VincErilla/Quake_Project/README.md

# Quake_Project
All files/programs used in creating the quake sensors
