VincErilla/Quake_Project/Quake-main/PCB/README.txt

Quake_PCB_3 has the most recent pcb for the quake project, the production files are the versions that were ready to go to JLC PCB with 5 being the most recent that includes the rtc.
