VincErilla/Quake_Project/(list of files, drawings)

Other design files:
Quake-main/PCB/Quake_PCB_3/Quake_PCB_3.dsn
