VincErilla/Quake_Project/Quake-main/PCB/Quake_PCB_3/Quake_PCB_3.kicad_pcb

## KiCad design Quake-main/PCB/Quake_PCB_3/Quake_PCB_3.kicad_pcb (2026-06-08)

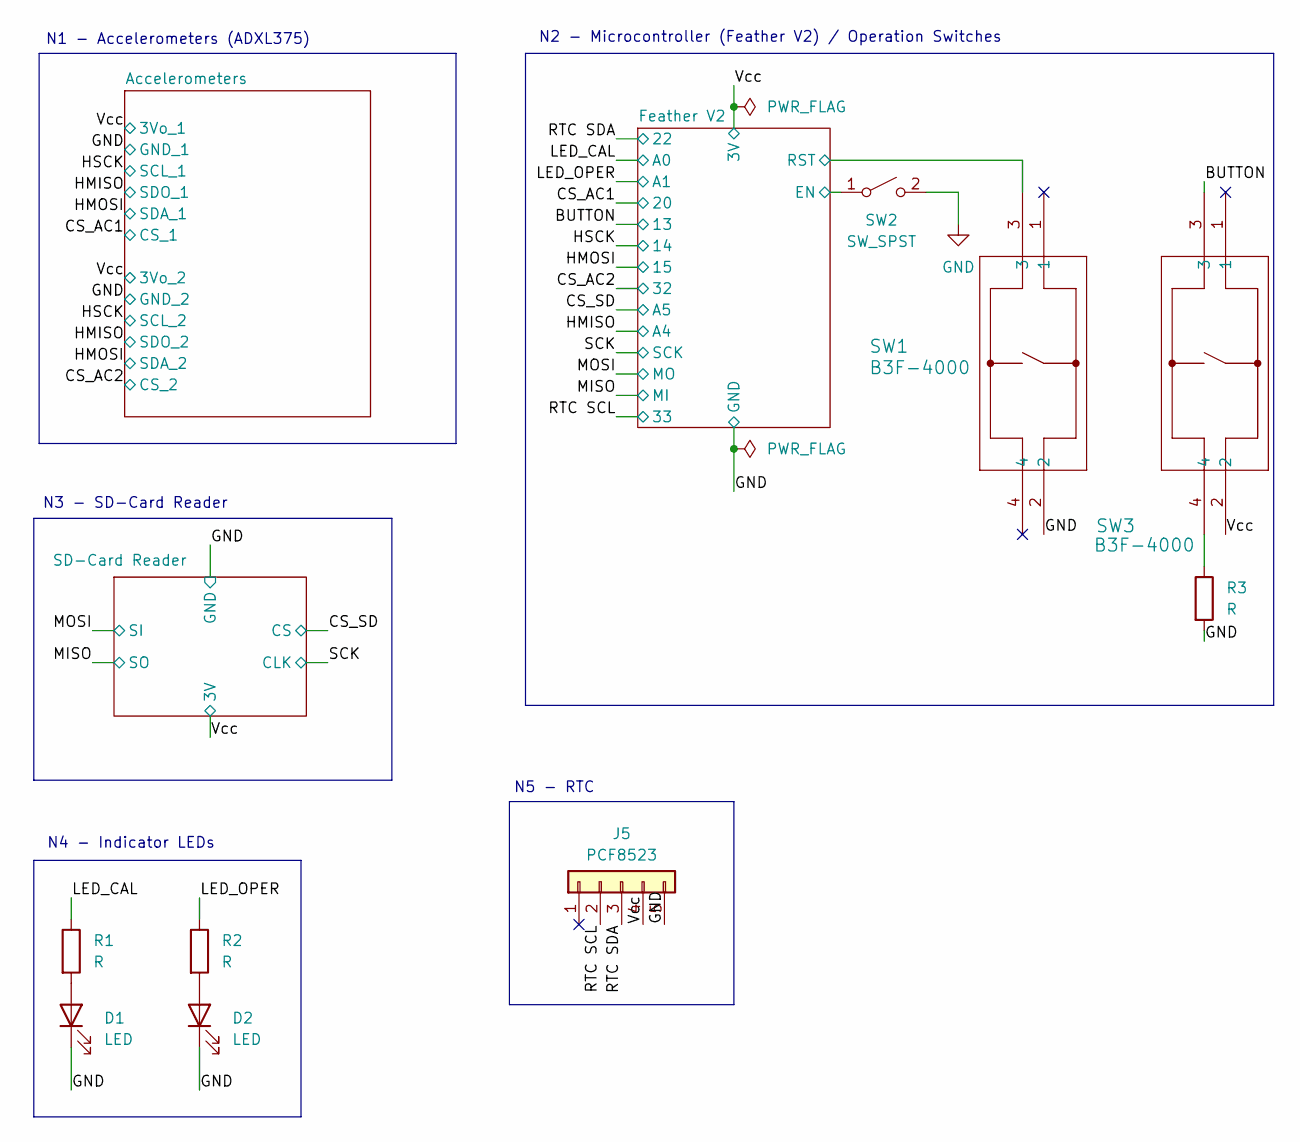
[picture p2: schematic Quake_PCB_3.kicad_sch, Quake PCB]

Parts:
D1, D2: LED; LED_D3.0mm
J5: PCF8523; PinHeader_1x05_P2.54mm_Vertical
R1, R2, R3: R; R_Axial_DIN0204_L3.6mm_D1.6mm_P7.62mm_Horizontal
SW1: B3F-4000; SW_B3F-4000_OMR
SW2: SW_SPST; PinHeader_1x02_P2.54mm_Vertical
SW3: B3F-4000; SW_SPST_Omron_B3F-40xx

Connections:
/BUTTON: SW3.3; also elsewhere on the board
/Feather V2/EN: SW2.1 (A); also elsewhere on the board
/Feather V2/RST: SW1.3; also elsewhere on the board
/LED_CAL: R1.1; also elsewhere on the board
/LED_OPER: R2.1; also elsewhere on the board
/RTC SCL: J5.2 (SCL); also elsewhere on the board
/RTC SDA: J5.3 (SDA); also elsewhere on the board
/Vcc: J5.4 (VCC), SW3.2; also elsewhere on the board
GND: D1.1 (K), D2.1 (K), J5.5 (GND), R3.2, SW1.2, SW2.2 (B); also elsewhere on the board
unnamed: D1.2 (A), R1.2
unnamed: D2.2 (A), R2.2
unnamed: R3.1, SW3.4

Notes on the sheet:
N4 - Indicator LEDs
N3 - SD-Card Reader
N5 - RTC
N1 - Accelerometers (ADXL375)
N2 - Microcontroller (Feather V2) / Operation Switches

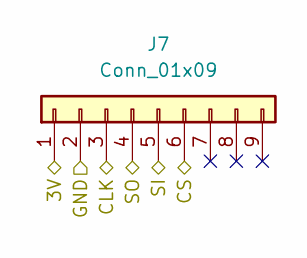
[picture p3: schematic sd_card_reader.kicad_sch]

Parts:
J7: Conn_01x09; PinHeader_1x09_P2.54mm_Vertical

Connections:
/CS_SD: J7.6; also elsewhere on the board
/MISO: J7.4; also elsewhere on the board
/MOSI: J7.5; also elsewhere on the board
/SCK: J7.3; also elsewhere on the board
/Vcc: J7.1; also elsewhere on the board
GND: J7.2; also elsewhere on the board

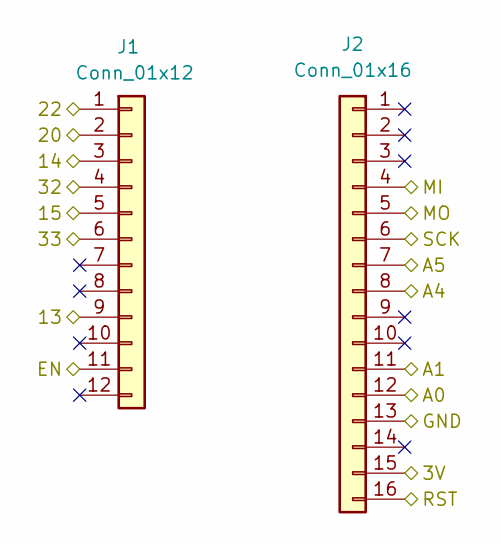
[picture p4: schematic feather_v2.kicad_sch]

Parts:
J1: Conn_01x12; PinHeader_1x12_P2.54mm_Vertical
J2: Conn_01x16; PinHeader_1x16_P2.54mm_Vertical

Connections:
/BUTTON: J1.9; also elsewhere on the board
/CS_AC1: J1.2; also elsewhere on the board
/CS_AC2: J1.4; also elsewhere on the board
/CS_SD: J2.7; also elsewhere on the board
/Feather V2/EN: J1.11; also elsewhere on the board
/Feather V2/RST: J2.16; also elsewhere on the board
/HMISO: J2.8; also elsewhere on the board
/HMOSI: J1.5; also elsewhere on the board
/HSCK: J1.3; also elsewhere on the board
/LED_CAL: J2.12; also elsewhere on the board
/LED_OPER: J2.11; also elsewhere on the board
/MISO: J2.4; also elsewhere on the board
/MOSI: J2.5; also elsewhere on the board
/RTC SCL: J1.6; also elsewhere on the board
/RTC SDA: J1.1; also elsewhere on the board
/SCK: J2.6; also elsewhere on the board
/Vcc: J2.15; also elsewhere on the board
GND: J2.13; also elsewhere on the board

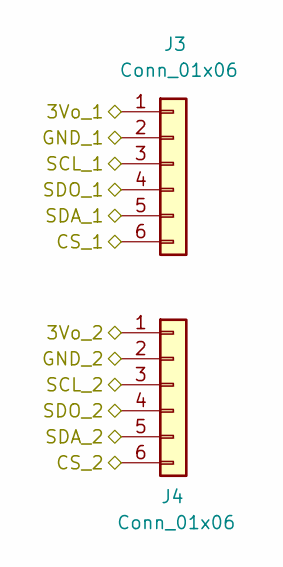
[picture p5: schematic accelerometers.kicad_sch]

Parts:
J3, J4: Conn_01x06; PinHeader_2x03_P2.54mm_Vertical

Connections:
/CS_AC1: J3.6; also elsewhere on the board
/CS_AC2: J4.6; also elsewhere on the board
/HMISO: J3.4, J4.4; also elsewhere on the board
/HMOSI: J3.5, J4.5; also elsewhere on the board
/HSCK: J3.3, J4.3; also elsewhere on the board
/Vcc: J3.1, J4.1; also elsewhere on the board
GND: J3.2, J4.2; also elsewhere on the board

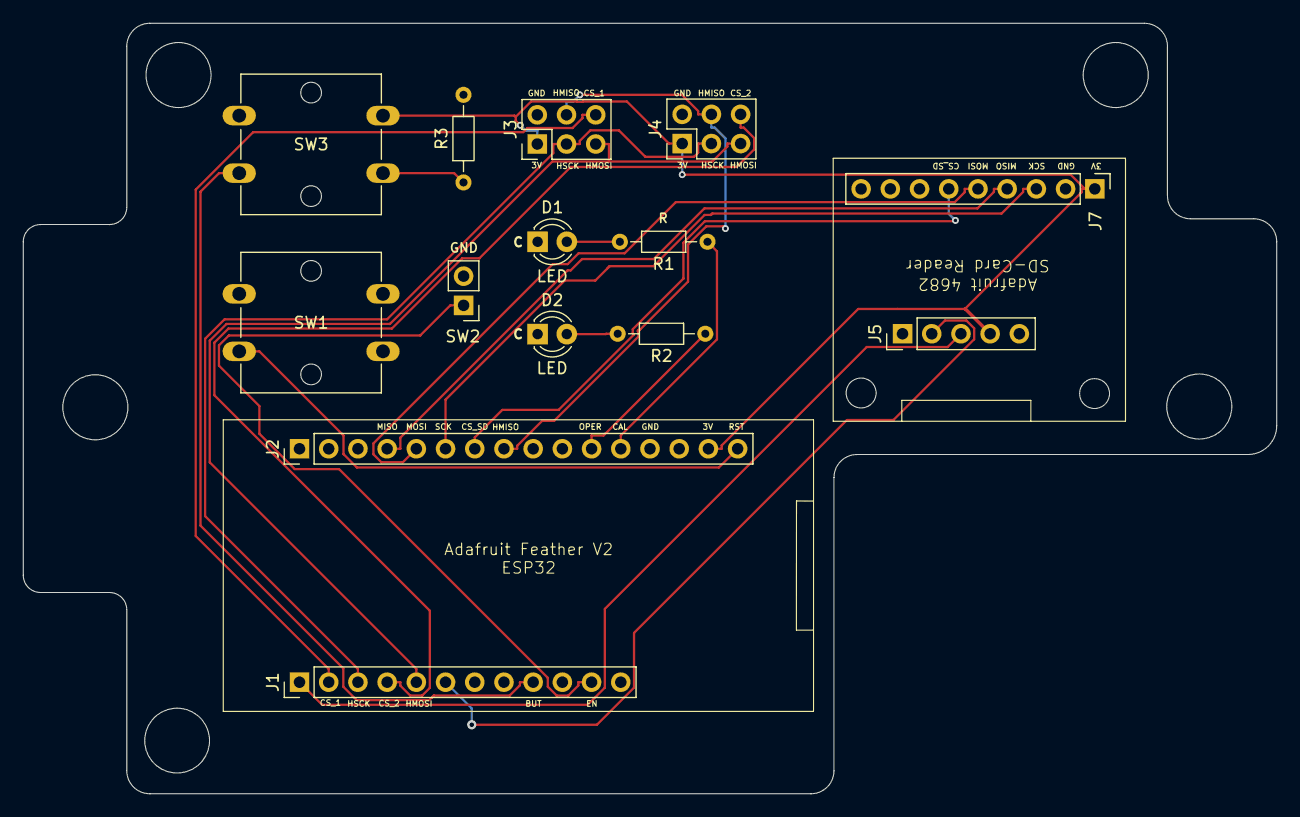
[picture p6: board Quake_PCB_3.kicad_pcb from above]

Board: 2 copper layers, 109.0 x 67.0 mm, 14 parts (0 on the bottom side), 21 nets.
