VincErilla/Quake_Project/(commit log)

2026-06-08 Most recent Files/Changes
    [Quake_PCB_3-B_Cu.gbl, Quake_PCB_3-B_Mask.gbs, Quake_PCB_3-B_Paste.gbp, Quake_PCB_3-B_Silkscreen.gbo, Quake_PCB_3-Edge_Cuts.gm1, Quake_PCB_3-F_Cu.gtl, Quake_PCB_3-F_Mask.gts, Quake_PCB_3-F_Paste.gtp]
2026-06-11 Changed a few things to acomodate another shielded cable. Flippin Brutal Burh
    [2accelSPIWifiRTC_Vibe7.ino]
2026-06-16 Added logic block to print which Accelerometer is failing
    [2accelSPIWifiRTC_Vibe7.ino, 2accelSPIWifi_Vibe4.ino]
2026-06-23 Changed the Vibe7 code to fit 2 accelerometers per ethernet. Will remove due to change of plans
2026-07-16 Added arduino code revised by Jacob with an LIS accel code. Additionally, did improvemnts on RTC logic in Vibe7
